EfraimFeinstein/3DPrinting/README.md

# 3DPrinting
Stuff I 3D print and release as open source
