EfraimFeinstein/3DPrinting/misc_parts/zuru_replacement/trials/cocking_mechanism/cocking_mechanism_notes.md

# Measurements

Total length of pin: 39 mm
Plastic covered length of pin: 14 mm
Diameter of pin: 4.3mm

Length of wider part: 45 mm
OD at widest point: 25 mm
OD at pin 14 mm
Widens in 5 mm

Ribbing indented every 7mm along the OD

Round the last 9mm

1.5 mm screwdriver indentation at the top
0.5 mm deep at the deepest point

# A, B, C
It is impossible to read which is which! If the pieces are not lifted/supported, the supports basically destroy the whole bottom, including the text.

Up at the end, the pin is closer to 4.5-4.6mm diameter

Only C had any chance and it is too narrow of a pin hole. Try 4.6-4.9

The flare looks like it will fit

The total height is a bit short

# D

Still too narrow for the pin

# E

Also too narrow

# F
 Also too narrow

 # G

 Fits, but can't get the pin in far enough, should be 2mm deeper

# H

Barely screws in

# I

Fits in all the way. 
Would work perfectly if glued
