EfraimFeinstein/3DPrinting/misc_parts/zuru_replacement/trials/air_chamber/zuru_replacement_notes.md

# A
Actual OD is 27.8 mm
O ring fits
Tight fit into the cylinder
5mm part does not fit
Screw does not fit
Screw hole location looks like it might be right
5mm hole should be centered farther into the piece. Actual is 0.9mm
real is 4.51-1.0-?

# B
O ring fits 
Easily slides in cylinder
5mm hole fits tightly, with little tolerance
But center is off 
If 5mm in, screw off
- actual distance to hole is 1.7mm (nominal 1.5?)

# C
O ring fit is loose
5mm hole fits well
possible to tap the screw, but difficult

# D
O ring is very loose
tapping screw still difficult
screw slot is not wide enough
Actual OD is 7.15, OD of slot hole is 8.4; must be inner 
Actual ID is 5.1

Is hole centering off? maybe ... it fits with difficulty

# E
still hard to get both the screw hole and the large hole in at the same time

with removed large hole and placed directly up against the edge, the screw hole does not go in

# F
also hard

# G
tappable and slightly hard screw hole

# H
tappable and easy screw hole

# I
screw hole too big
possible but hard to get it in
it is hard to get on, but it does go on

# J
Does not fit either

With the large hole removed and the screw hole placed directly against the piece, the screw hole slides in easily. 

***
Using the screw diameter from G and the large hole distance from I; the screw hole distance from J is correct

# K
still very hard to get in (could not do it on first try)

# L
goes in, but with some difficulty

# M
perfect fit!
