EfraimFeinstein/3DPrinting/misc_parts/zuru_replacement/cocking_mechanism_final.stl

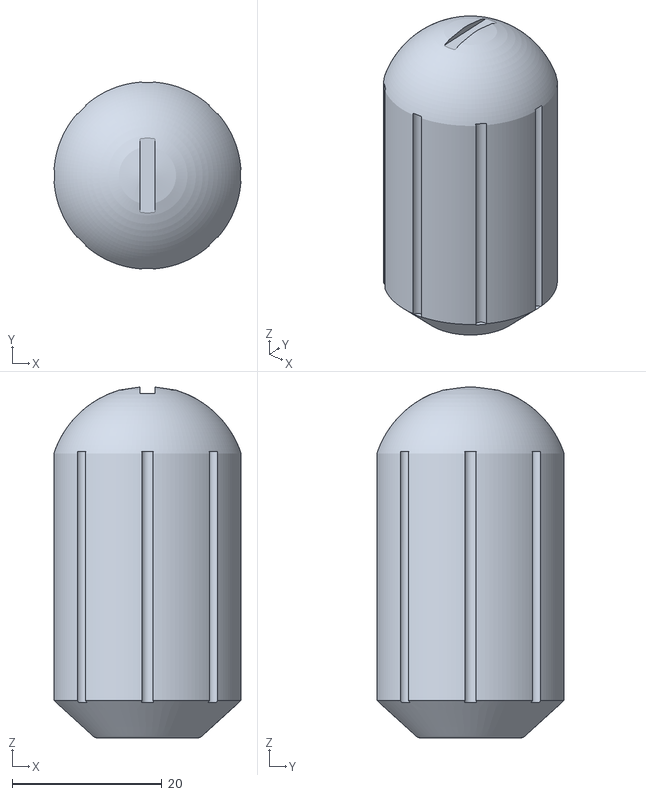
[picture p1: CAD file, 2026-06-11]
misc_parts/zuru_replacement/cocking_mechanism_final.stl
25.0 x 25.0 x 46.9
