EfraimFeinstein/3DPrinting/misc_parts/zuru_replacement/zuru_replacement_final.stl

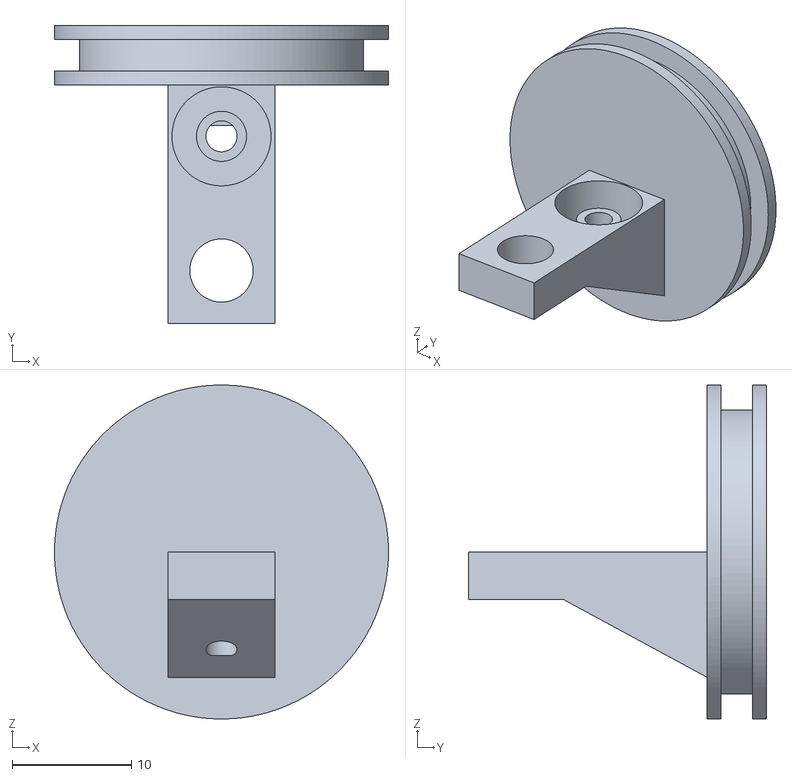
[picture p2: CAD file, 2026-05-30]
misc_parts/zuru_replacement/zuru_replacement_final.stl
28.0 x 25.0 x 28.0
