EfraimFeinstein/3DPrinting/(commit log)

2026-05-30 initial commit of zuru replacement part + instructions
    [zuru_replacement_final.stl]
2026-06-11 Cocking mechanism fix (#1)
    * move files
    * cocking mechanism fix
    * trials
    [cocking_mechanism_final.stl]
